vsi5004/RDJ-Turntable/docs/hmi-minimal-preview.png

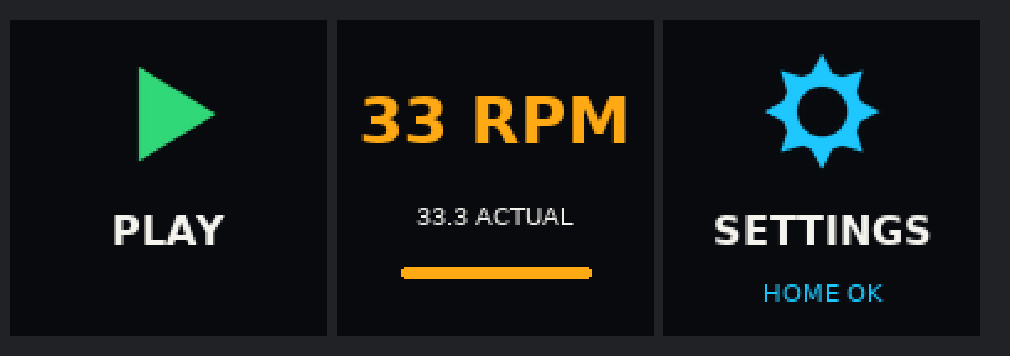
docs/hmi-minimal-preview.png
