vsi5004/RDJ-Turntable/RDJ-Turntable.ioc

Mcu.UserName=STM32F407VETx
PA0-WKUP.Signal=S_TIM2_CH1_ETR
PA1.Signal=S_TIM2_CH2
PA10.Signal=S_TIM1_CH3
PA13.Signal=SYS_JTMS-SWDIO
PA14.Signal=SYS_JTCK-SWCLK
PA2.GPIO_Label=PLAT_INDEX
PA2.Signal=GPXTI2
PA4.GPIO_Label=MT_CS
PA4.Signal=GPIO_Output
PA5.Signal=SPI1_SCK
PA6.Signal=SPI1_MISO
PA7.Signal=SPI1_MOSI
PA8.Signal=S_TIM1_CH1
PA9.Signal=S_TIM1_CH2
PB0.Signal=S_TIM3_CH3
PB10.Signal=SPI2_SCK
PB12.GPIO_Label=AS_CS
PB12.Signal=GPIO_Output
PB13.GPIO_Label=PLAT_EN
PB13.Signal=GPIO_Output
PB14.GPIO_Label=PLAT_FAULT
PB14.Signal=GPIO_Input
PB15.Signal=S_TIM12_CH2
PB3.Signal=SPI3_SCK
PB5.Signal=SPI3_MOSI
PB8.Signal=CAN1_RX
PB9.Signal=CAN1_TX
PC0.Signal=ADCx_IN10
PC13-ANTI_TAMP.GPIO_Label=LED
PC13-ANTI_TAMP.Signal=GPIO_Output
PC2.Signal=SPI2_MISO
PC3.Signal=SPI2_MOSI
PC4.GPIO_Label=ARM_EN
PC4.Signal=GPIO_Output
PC5.GPIO_Label=ARM_FAULT
PC5.Signal=GPIO_Input
PC6.Signal=S_TIM3_CH1
PC7.Signal=S_TIM3_CH2
PD12.GPIO_Label=DISP_BL
PD12.Signal=S_TIM4_CH1
PE10.GPIO_Label=KEY2
PE10.Signal=GPIO_Input
PE2.GPIO_Label=DISP_DC
PE2.Signal=GPIO_Output
PE3.GPIO_Label=DISP_RST
PE3.Signal=GPIO_Output
PE4.GPIO_Label=DISP_CS0
PE4.Signal=GPIO_Output
PE5.GPIO_Label=DISP_CS1
PE5.Signal=GPIO_Output
PE6.GPIO_Label=DISP_CS2
PE6.Signal=GPIO_Output
PE7.GPIO_Label=ARM_HOME
PE7.Signal=GPXTI7
PE8.GPIO_Label=KEY0
PE8.Signal=GPIO_Input
PE9.GPIO_Label=KEY1
PE9.Signal=GPIO_Input
PH0-OSC_IN.Signal=RCC_OSC_IN
PH1-OSC_OUT.Signal=RCC_OSC_OUT
