vsi5004/RDJ-Turntable/Core/Inc/main.h

#define DISP_DC_Pin GPIO_PIN_2
#define DISP_DC_GPIO_Port GPIOE
#define DISP_RST_Pin GPIO_PIN_3
#define DISP_RST_GPIO_Port GPIOE
#define DISP_CS0_Pin GPIO_PIN_4
#define DISP_CS0_GPIO_Port GPIOE
#define DISP_CS1_Pin GPIO_PIN_5
#define DISP_CS1_GPIO_Port GPIOE
#define DISP_CS2_Pin GPIO_PIN_6
#define DISP_CS2_GPIO_Port GPIOE
#define LED_Pin GPIO_PIN_13
#define LED_GPIO_Port GPIOC
#define PLAT_INDEX_Pin GPIO_PIN_2
#define PLAT_INDEX_GPIO_Port GPIOA
#define PLAT_INDEX_EXTI_IRQn EXTI2_IRQn
#define MT_CS_Pin GPIO_PIN_4
#define MT_CS_GPIO_Port GPIOA
#define ARM_EN_Pin GPIO_PIN_4
#define ARM_EN_GPIO_Port GPIOC
#define ARM_FAULT_Pin GPIO_PIN_5
#define ARM_FAULT_GPIO_Port GPIOC
#define ARM_HOME_Pin GPIO_PIN_7
#define ARM_HOME_GPIO_Port GPIOE
#define ARM_HOME_EXTI_IRQn EXTI9_5_IRQn
#define KEY0_Pin GPIO_PIN_8
#define KEY0_GPIO_Port GPIOE
#define KEY1_Pin GPIO_PIN_9
#define KEY1_GPIO_Port GPIOE
#define KEY2_Pin GPIO_PIN_10
#define KEY2_GPIO_Port GPIOE
#define AS_CS_Pin GPIO_PIN_12
#define AS_CS_GPIO_Port GPIOB
#define PLAT_EN_Pin GPIO_PIN_13
#define PLAT_EN_GPIO_Port GPIOB
#define PLAT_FAULT_Pin GPIO_PIN_14
#define PLAT_FAULT_GPIO_Port GPIOB
#define DISP_BL_Pin GPIO_PIN_12
#define DISP_BL_GPIO_Port GPIOD
