vsi5004/RDJ-Turntable/App/diagnostics/m2c_executor.cpp

#include "m2c_executor.hpp"

#include "control/arm_foc.h"
#include "control/as5048a.h"
#include "control/foc.h"
#include "control/mt6826s.h"
#include "nvm.h"
#include "trace.h"

#include <cmath>

namespace diagnostics {
namespace {

constexpr float kPi = 3.14159265358979f;
constexpr float kTwoPi = 2.0f * kPi;
constexpr float kOpenLoopElecVel = kTwoPi;
constexpr float kBeltRatio = 90.0f / 24.0f;
constexpr float kMotorVelocity33 = 33.3333f * kBeltRatio * (kTwoPi / 60.0f);
constexpr float kCalRpm = 180.0f;
constexpr uint8_t kCalFreq = 0x5;
constexpr float kCalVoltage = 3.0f;
constexpr float kArmJogStep = kPi / 2.0f; /* default carriage jog: 90 deg motor angle */
constexpr uint32_t kJogSettleMs = 300;    /* min dwell before a jog can report Complete */
constexpr uint32_t kJogTimeoutMs = 4000;  /* jog must reach target within this or it fails */

float shortest_delta(float a, float b)
{
    float d = a - b;
    if (d > kPi) d -= kTwoPi;
    if (d < -kPi) d += kTwoPi;
    return d;
}

}  // namespace

/* --- Per-motor dispatch: the platter (foc/MT6826S) and the tonearm carriage (arm_foc/AS5048A) are
 * the same axis abstraction for the shared diagnostics (electrical align, encoder read, stop,
 * fault). Routing by command_.target lets the align state machine below serve both motors. --- */

bool M2cExecutor::is_tonearm() const { return command_.target == Target::TonearmCarriage; }

void M2cExecutor::motor_hold_electrical_angle(float theta_el)
{
    if (is_tonearm()) arm_foc::hold_electrical_angle(theta_el);
    else              foc::hold_electrical_angle(theta_el);
}

void M2cExecutor::motor_set_open_loop_electrical_velocity(float elec_rad_s)
{
    if (is_tonearm()) arm_foc::set_open_loop_electrical_velocity(elec_rad_s);
    else              foc::set_open_loop_electrical_velocity(elec_rad_s);
}

bool M2cExecutor::motor_faulted() const
{
    return is_tonearm() ? arm_foc::faulted() : foc::faulted();
}

bool M2cExecutor::commit_alignment(float offset, int dir)
{
    if (is_tonearm()) {
        arm_foc::zero_elec_offset = offset;
        arm_foc::direction = static_cast<int8_t>(dir);
        arm_foc::alignment_valid = true;
        return nvm::save(nvm::Slot::Tonearm, nvm::Cal{offset, dir});
    }
    foc::zero_elec_offset = offset;
    foc::direction = static_cast<int8_t>(dir);
    foc::alignment_valid = true;
    return nvm::save(nvm::Slot::Platter, nvm::Cal{foc::zero_elec_offset, foc::direction});
}

/* Stop BOTH motors. Diagnostics never drives both at once, so disabling both on any abort/exit is
 * the safe default and avoids leaving the inactive axis energized. */
void M2cExecutor::stop_motors()
{
    foc::stop();
    arm_foc::stop();
}

bool M2cExecutor::start(const Command& command)
{
    if (phase_ != Phase::Idle) return false;
    command_ = command;
    report_ = {ExecutionState::Running};
    phase_started_ms_ = clock_.now_ms();

    switch (command.action) {
    case Action::ReadStatus:
        phase_ = Phase::ReadStatus;
        return true;
    case Action::OpenLoopSpin:
        spin_elec_vel_ = command.parameters.value != 0.0f ? command.parameters.value
                                                          : kOpenLoopElecVel;
        motor_set_open_loop_electrical_velocity(spin_elec_vel_);
        phase_ = Phase::Continuous;
        trace_ms_ = clock_.now_ms();
        spin_mech_accum_ = 0.0f;
        spin_primed_ = false;
        TRACE(is_tonearm() ? "diag: tonearm open-loop spin (auto pole-pair count)\n"
                           : "diag: platter open-loop started\n");
        return true;
    case Action::ElectricalAlign:
        motor_hold_electrical_angle(0.0f);
        phase_ = Phase::AlignWaitZero;
        TRACE("diag: electrical alignment started\n");
        return true;
    case Action::EncoderAutoCal:
        mt6826s::set_autocal_freq(kCalFreq);
        saved_voltage_limit_ = foc::voltage_limit;
        cal_voltage_saved_ = true;
        foc::voltage_limit = kCalVoltage;
        cal_ramp_step_ = 1;
        foc::set_open_loop_electrical_velocity(
            (kCalRpm / 60.0f) * kTwoPi * foc::pole_pairs / 40.0f);
        phase_ = Phase::CalRamp;
        TRACE("diag: encoder auto-cal ramp started\n");
        return true;
    case Action::ClosedLoopVelocity: {
        const float target =
            command.parameters.value != 0.0f ? command.parameters.value : kMotorVelocity33;
        report_.platter_calibrated = foc::alignment_valid;
        if (foc::alignment_valid) {
            foc::set_closed_loop_velocity(target);
            TRACE("diag: platter velocity loop started (closed-loop)\n");
        } else {
            /* No stored alignment: spin open-loop at the same target so wiring can be checked.
             * The UI shows OPEN so the operator knows to run align/auto-cal for closed-loop. */
            foc::set_open_loop_velocity(target);
            TRACE("diag: platter velocity open-loop fallback; run align/cal\n");
        }
        phase_ = Phase::Continuous;
        return true;
    }
    case Action::Jog: {
        /* Tonearm carriage position jog (closed-loop position needs commutation alignment first). */
        if (!arm_foc::alignment_valid) {
            report_ = {ExecutionState::Failed, -10};
            TRACE("diag: jog rejected; tonearm not aligned\n");
            return false;
        }
        const float delta =
            command.parameters.value != 0.0f ? command.parameters.value : kArmJogStep;
        arm_foc::jog(delta);
        phase_ = Phase::JogSettle;
        trace_ms_ = clock_.now_ms();
        TRACE("diag: tonearm carriage jog started\n");
        return true;
    }
    case Action::Stop:
        safe_stop();
        report_ = {ExecutionState::Complete};
        return true;
    default:
        report_ = {ExecutionState::Failed, -1};
        return false;
    }
}

void M2cExecutor::abort()
{
    if (phase_ == Phase::CalPoll) mt6826s::stop_autocal();
    stop_motors();
    restore_calibration_voltage();
    phase_ = Phase::Idle;
    report_ = {ExecutionState::Idle};
    TRACE("diag: operation aborted; motors disabled\n");
}

void M2cExecutor::safe_stop()
{
    if (phase_ == Phase::CalPoll) mt6826s::stop_autocal();
    stop_motors();
    restore_calibration_voltage();
    phase_ = Phase::Idle;
    report_ = {ExecutionState::Idle};
}

ExecutionReport M2cExecutor::poll()
{
    report_.platter_calibrated = foc::alignment_valid;
    if (phase_ == Phase::Idle) return report_;

    if (motor_faulted()) {
        finish(ExecutionState::Failed, -2);
        return report_;
    }

    switch (phase_) {
    case Phase::Continuous:
        if (command_.action == Action::ClosedLoopVelocity) {
            report_.primary = foc::velocity();
            report_.secondary = foc::applied_uq();
        } else { /* OpenLoopSpin (any motor): auto pole-pair count */
            estimate_pole_pairs();
        }
        break;

    case Phase::ReadStatus: {
        mt6826s::Reading reading;
        mt6826s::read(reading);
        report_.primary = mt6826s::degrees(reading.angle);
        report_.secondary = static_cast<float>(reading.status);
        finish(reading.crc_ok ? ExecutionState::Complete : ExecutionState::Failed,
               reading.crc_ok ? 0 : -3);
        break;
    }

    case Phase::AlignWaitZero:
        if (elapsed(900)) {
            if (!read_mechanical_rad(align_m0_)) {
                finish(ExecutionState::Failed, -3);
                break;
            }
            motor_hold_electrical_angle(kPi / 3.0f);
            phase_started_ms_ = clock_.now_ms();
            phase_ = Phase::AlignWaitStep;
        }
        break;

    case Phase::AlignWaitStep:
        if (elapsed(900)) {
            float m1 = 0.0f;
            if (!read_mechanical_rad(m1)) {
                finish(ExecutionState::Failed, -3);
                break;
            }
            const float dmech = shortest_delta(m1, align_m0_);
            const int dir = dmech >= 0.0f ? 1 : -1;
            const bool saved = commit_alignment(align_m0_, dir); /* persists to flash per motor */
            report_.primary = align_m0_ * (180.0f / kPi);
            report_.secondary = dmech * (180.0f / kPi);
            TRACE("diag: align offset=%u deg dir=%c save=%s\n",
                  static_cast<unsigned>(report_.primary), dir > 0 ? '+' : '-',
                  saved ? "OK" : "FAILED");
            finish(saved ? ExecutionState::Complete : ExecutionState::Failed, saved ? 0 : -4);
        }
        break;

    case Phase::CalRamp:
        if (elapsed(50)) {
            ++cal_ramp_step_;
            if (cal_ramp_step_ > 40) {
                phase_ = Phase::CalSettle;
            } else {
                const float target = (kCalRpm / 60.0f) * kTwoPi * foc::pole_pairs;
                foc::set_open_loop_electrical_velocity(target * cal_ramp_step_ / 40.0f);
            }
            phase_started_ms_ = clock_.now_ms();
        }
        break;

    case Phase::CalSettle:
        if (elapsed(1000)) {
            if (!read_mechanical_rad(cal_angle0_)) {
                finish(ExecutionState::Failed, -3);
                break;
            }
            phase_started_ms_ = clock_.now_ms();
            phase_ = Phase::CalMeasure;
        }
        break;

    case Phase::CalMeasure:
        if (elapsed(100)) {
            float angle1 = 0.0f;
            if (!read_mechanical_rad(angle1)) {
                finish(ExecutionState::Failed, -3);
                break;
            }
            const float delta = shortest_delta(angle1, cal_angle0_);
            const float rpm = std::fabs((delta / 0.1f) * (60.0f / kTwoPi));
            report_.primary = rpm;
            if (rpm < 80.0f || rpm > 200.0f) {
                TRACE("diag: auto-cal speed out of band (%ld RPM)\n",
                      static_cast<long>(rpm));
                finish(ExecutionState::Failed, -5);
            } else {
                mt6826s::start_autocal();
                cal_poll_count_ = 0;
                phase_started_ms_ = clock_.now_ms();
                phase_ = Phase::CalPoll;
                TRACE("diag: encoder auto-cal running\n");
            }
        }
        break;

    case Phase::CalPoll:
        if (elapsed(100)) {
            phase_started_ms_ = clock_.now_ms();
            ++cal_poll_count_;
            const mt6826s::CalStatus status = mt6826s::autocal_status();
            report_.secondary = static_cast<float>(status);
            if (status == mt6826s::CalStatus::Success) {
                TRACE("diag: encoder auto-cal success; power-cycle required\n");
                finish(ExecutionState::Complete);
            } else if (status == mt6826s::CalStatus::Failed || cal_poll_count_ >= 200) {
                mt6826s::stop_autocal();
                finish(ExecutionState::Failed,
                       status == mt6826s::CalStatus::Failed ? -6 : -7);
            }
        }
        break;

    case Phase::JogSettle: {
        const float pos_deg = arm_foc::position() * (180.0f / kPi);
        const float tgt_deg = arm_foc::position_target() * (180.0f / kPi);
        report_.primary = pos_deg;
        report_.secondary = tgt_deg - pos_deg;
        if (static_cast<uint32_t>(clock_.now_ms() - trace_ms_) >= 100) {
            trace_ms_ = clock_.now_ms();
            /* All fields integer to stay clear of float printf: positions/error in deci-degrees,
             * Uq in mV, velocity in milli-rad/s. */
            TRACE("diag: jog tgt=%ld pos=%ld err=%ld [deci-deg] Uq=%ldmV vel=%ldmrad/s\n",
                  static_cast<long>(tgt_deg * 10.0f), static_cast<long>(pos_deg * 10.0f),
                  static_cast<long>((tgt_deg - pos_deg) * 10.0f),
                  static_cast<long>(arm_foc::applied_uq() * 1000.0f),
                  static_cast<long>(arm_foc::velocity() * 1000.0f));
        }
        if (arm_foc::position_settled() && elapsed(kJogSettleMs)) {
            /* Target reached. Keep arm_foc in Position mode HOLDING (do not stop the motor); just
             * mark the command complete so the controller returns to Ready while the carriage holds.
             * The next jog adds to the held target; exit/abort disables the motor. */
            phase_ = Phase::Idle;
            report_.state = ExecutionState::Complete;
            report_.result_code = 0;
            TRACE("diag: tonearm jog reached target (holding)\n");
        } else if (elapsed(kJogTimeoutMs)) {
            finish(ExecutionState::Failed, -11);
            TRACE("diag: tonearm jog did not reach target\n");
        }
        break;
    }

    case Phase::Idle:
        break;
    }

    return report_;
}

void M2cExecutor::estimate_pole_pairs()
{
    /* Open-loop spin: the ISR drives the electrical angle but does NOT sample the encoder (true for
     * both foc and arm_foc), so reading it here on the main loop is safe. The commanded electrical
     * angle is exactly vel*time, and a synchronous rotor advances mech = elec / pole_pairs, so
     * pole_pairs = elec_travelled / mech_travelled. Motor-agnostic via read_mechanical_rad(). */
    float mech = 0.0f;
    if (!read_mechanical_rad(mech)) return;

    if (!spin_primed_) {
        if (elapsed(500)) { /* let the rotor lock to the open-loop field before measuring */
            spin_mech_prev_ = mech;
            spin_mech_accum_ = 0.0f;
            spin_accum_ms_ = clock_.now_ms();
            spin_primed_ = true;
        }
        return;
    }

    float d = mech - spin_mech_prev_;
    if (d > kPi) d -= kTwoPi;
    if (d < -kPi) d += kTwoPi;
    spin_mech_accum_ += d;
    spin_mech_prev_ = mech;

    const float elec =
        spin_elec_vel_ * static_cast<float>(clock_.now_ms() - spin_accum_ms_) / 1000.0f;
    const float mech_mag = std::fabs(spin_mech_accum_);
    if (mech_mag <= 0.20f) return; /* wait for enough travel for a stable ratio */

    report_.primary = std::fabs(elec) / mech_mag;
    if (static_cast<uint32_t>(clock_.now_ms() - trace_ms_) < 250) return;
    trace_ms_ = clock_.now_ms();
    const int32_t p100 = static_cast<int32_t>(report_.primary * 100.0f);
    TRACE("diag: %s pole_pairs est=%ld.%02ld (mech %ld deg)\n",
          is_tonearm() ? "tonearm" : "platter", static_cast<long>(p100 / 100),
          static_cast<long>(p100 % 100), static_cast<long>(mech_mag * 180.0f / kPi));
}

bool M2cExecutor::read_mechanical_rad(float& angle)
{
    if (is_tonearm()) {
        as5048a::Reading r;
        as5048a::read(r);
        if (!r.parity_ok) return false;
        angle = static_cast<float>(r.angle) * (kTwoPi / 16384.0f); /* AS5048A 14-bit */
        return true;
    }
    mt6826s::Reading reading;
    mt6826s::read(reading);
    if (!reading.crc_ok) return false;
    angle = static_cast<float>(reading.angle) * (kTwoPi / 32768.0f); /* MT6826S 15-bit */
    return true;
}

void M2cExecutor::finish(ExecutionState state, int32_t result_code)
{
    if (phase_ == Phase::CalPoll && state == ExecutionState::Failed)
        mt6826s::stop_autocal();
    stop_motors();
    restore_calibration_voltage();
    phase_ = Phase::Idle;
    report_.state = state;
    report_.result_code = result_code;
}

void M2cExecutor::restore_calibration_voltage()
{
    if (!cal_voltage_saved_) return;
    foc::voltage_limit = saved_voltage_limit_;
    cal_voltage_saved_ = false;
}

bool M2cExecutor::elapsed(uint32_t duration_ms) const
{
    return static_cast<uint32_t>(clock_.now_ms() - phase_started_ms_) >= duration_ms;
}

}  // namespace diagnostics
