vsi5004/RDJ-Turntable/App/platform/nvm.h

/**
 * nvm.h - tiny non-volatile store for commutation-critical calibration, in MCU flash.
 *
 * Holds the FOC alignment (zero electrical offset + direction sign) so the platter motor
 * commutates correctly from boot without re-aligning each power-on. Lives in internal flash
 * (not the removable SD card) precisely because the motor depends on it. One dedicated flash
 * sector; writes are rare (only on re-align), well within endurance.
 */
#pragma once
#include <cstdint>

namespace nvm {

/* One alignment per motor, each in its own dedicated flash sector. */
enum class Slot : uint8_t {
    Platter, /* sector 7 @ 0x08060000 */
    Tonearm, /* sector 6 @ 0x08040000 */
};

struct Cal {
    float   zero_offset; /* mechanical angle (rad) where theta_elec == 0 */
    int32_t direction;   /* +1 / -1 */
};

/* Load the stored calibration for a motor. Returns false if none is present / fails validation. */
bool load(Slot slot, Cal& out);

/* Erase + program a motor's calibration sector. Returns true on success. Stalls the CPU for the
 * duration of the sector erase (~1 s) — call only with the motors stopped. */
bool save(Slot slot, const Cal& in);

}  // namespace nvm
