vsi5004/RDJ-Turntable/App/hmi/screenkey_demo.cpp

#include "screenkey_demo.hpp"

namespace hmi {
namespace {

float selected_rpm(turntable::RecordSpeed speed)
{
    return speed == turntable::RecordSpeed::Rpm45 ? 45.0f : 33.3333f;
}

bool is_playback_state(turntable::State state)
{
    using turntable::State;
    switch (state) {
    case State::SpinningUpForPlay:
    case State::SeekingLeadIn:
    case State::LoweringForPlay:
    case State::Playing:
    case State::RaisingForPause:
    case State::Paused:
    case State::LoweringForResume:
    case State::RaisingForSpeedChange:
    case State::ChangingSpeedForPlayback:
    case State::LoweringAfterSpeedChange:
    case State::ChangingSpeedWhilePaused:
    case State::RaisingForStop:
    case State::ReturningHomeWithPlatter:
    case State::StoppingPlatter:
    case State::SpinningUpForResume:
        return true;
    default:
        return false;
    }
}

constexpr int16_t kRippleMillirpm[] = {
    0, 6, 13, 20, 25, 28, 26, 21, 14, 6, -2, -10, -17, -22, -25, -23,
    -18, -10, -1, 8, 16, 22, 25, 23, 18, 11, 4, -3, -9, -12, -10, -5,
};

}  // namespace

void ScreenKeyDemo::reset(uint32_t now_ms)
{
    interaction_ = InteractionController(interaction_config_);
    application_ = {};
    application_.authority = turntable::ControlAuthority::Normal;
    application_.state = turntable::ApplicationState::Normal;
    application_.turntable.selected_speed = turntable::RecordSpeed::Rpm33;
    application_.turntable.home = turntable::HomeConfidence::Unknown;
    application_.turntable.lift.position = turntable::LiftPosition::Unknown;
    application_.turntable.lift.confidence = turntable::PositionConfidence::Unknown;
    deadline_ = Deadline::None;
    deadline_started_ms_ = now_ms;
    deadline_duration_ms_ = 0;
    speed_trace_.reset();
    set_state(turntable::State::NeedsHome);
}

void ScreenKeyDemo::handle(Key key, Gesture gesture, uint32_t now_ms)
{
    interaction_.synchronize(application_);
    if (key == Key::Settings && gesture == Gesture::Hold
        && application_.authority == turntable::ControlAuthority::Normal
        && interaction_.snapshot().mode == Mode::Primary) {
        inject_product_fault();
        return;
    }
    apply(interaction_.handle(key, gesture, application_), now_ms);
}

void ScreenKeyDemo::tick(uint32_t now_ms)
{
    update_speed_trace(now_ms);
    if (application_.authority == turntable::ControlAuthority::Diagnostic && diagnostic_ != nullptr) {
        diagnostic_->tick();
        sync_diagnostic();
    }
    if (deadline_ == Deadline::None
        || static_cast<uint32_t>(now_ms - deadline_started_ms_) < deadline_duration_ms_)
        return;
    const Deadline elapsed = deadline_;
    deadline_ = Deadline::None;
    advance(elapsed, now_ms);
    interaction_.synchronize(application_);
}

void ScreenKeyDemo::apply(const Intent& intent, uint32_t now_ms)
{
    switch (intent.type) {
    case IntentType::None:
        break;
    case IntentType::TurntableEvent:
        apply_turntable_event(intent.event, now_ms);
        break;
    case IntentType::EnterDiagnostics:
        application_.state = turntable::ApplicationState::EnteringDiagnostic;
        application_.turntable.lift.motion = turntable::MotionState::Moving;
        schedule(Deadline::FinishDiagnosticEntry, 600, now_ms);
        break;
    case IntentType::ExitDiagnostics:
        if (diagnostic_ != nullptr) diagnostic_->request_exit();
        application_.state = turntable::ApplicationState::ExitingDiagnostic;
        schedule(Deadline::FinishDiagnosticExit, 500, now_ms);
        sync_diagnostic();
        break;
    case IntentType::SubmitDiagnostic:
        if (diagnostic_ != nullptr) diagnostic_->submit(intent.diagnostic);
        sync_diagnostic();
        break;
    case IntentType::AbortDiagnostic:
        if (diagnostic_ != nullptr) diagnostic_->abort();
        sync_diagnostic();
        break;
    case IntentType::AcknowledgeDiagnosticFault:
        if (diagnostic_ != nullptr) diagnostic_->acknowledge_fault();
        sync_diagnostic();
        break;
    }
}

void ScreenKeyDemo::apply_turntable_event(const turntable::Event& event, uint32_t now_ms)
{
    using turntable::EventType;
    using turntable::State;
    switch (event.type) {
    case EventType::InitializeRequested:
        set_state(State::RaisingForInitialization);
        schedule(Deadline::BeginHoming, 600, now_ms);
        break;
    case EventType::CancelRequested:
        deadline_ = Deadline::None;
        set_state(State::NeedsHome);
        break;
    case EventType::PlayRequested:
        speed_trace_.reset();
        set_state(State::SpinningUpForPlay);
        schedule(Deadline::BeginSeeking, 1000, now_ms);
        break;
    case EventType::PauseRequested:
        set_state(State::RaisingForPause);
        schedule(Deadline::FinishPause, 600, now_ms);
        break;
    case EventType::ResumeRequested:
        set_state(State::LoweringForResume);
        schedule(Deadline::FinishResume, 600, now_ms);
        break;
    case EventType::StopRequested:
        if (application_.turntable.state == State::Interrupted) {
            set_state(State::ReturningHomeWithoutPlatter);
            schedule(Deadline::FinishReturnWithoutPlatter, 800, now_ms);
        } else {
            set_state(State::RaisingForStop);
            schedule(Deadline::BeginReturn, 600, now_ms);
        }
        break;
    case EventType::SpeedChangeRequested:
        speed_trace_.reset();
        application_.turntable.selected_speed = event.speed;
        if (application_.turntable.state == State::Playing) {
            set_state(State::RaisingForSpeedChange);
            schedule(Deadline::BeginSpeedChange, 600, now_ms);
        } else if (application_.turntable.state == State::Paused) {
            set_state(State::ChangingSpeedWhilePaused);
            schedule(Deadline::FinishSpeedChange, 800, now_ms);
        } else {
            update_actions();
        }
        break;
    case EventType::AcknowledgeFaultRequested:
        application_.turntable.fault = {};
        set_state(application_.turntable.home == turntable::HomeConfidence::Valid
                      ? State::Interrupted : State::NeedsHome);
        break;
    case EventType::MaintenanceCancelRequested:
        set_state(application_.turntable.home == turntable::HomeConfidence::Valid
                      ? State::Idle : State::NeedsHome);
        break;
    default:
        break;
    }
}

void ScreenKeyDemo::set_state(turntable::State state)
{
    application_.turntable.state = state;
    using turntable::LiftPosition;
    using turntable::MotionState;
    using turntable::State;
    switch (state) {
    case State::RaisingForInitialization:
    case State::RaisingForPause:
    case State::RaisingForSpeedChange:
    case State::RaisingForStop:
        application_.turntable.lift.motion = MotionState::Moving;
        break;
    case State::LoweringForPlay:
    case State::LoweringForResume:
    case State::LoweringAfterSpeedChange:
        application_.turntable.lift.motion = MotionState::Moving;
        break;
    case State::Playing:
        application_.turntable.lift.position = LiftPosition::Lowered;
        application_.turntable.lift.motion = MotionState::Idle;
        application_.turntable.measured_rpm = selected_rpm(application_.turntable.selected_speed);
        application_.turntable.speed_locked = true;
        break;
    case State::Paused:
        application_.turntable.lift.position = LiftPosition::Raised;
        application_.turntable.lift.motion = MotionState::Idle;
        application_.turntable.measured_rpm = selected_rpm(application_.turntable.selected_speed);
        application_.turntable.speed_locked = true;
        break;
    case State::Idle:
    case State::NeedsHome:
        speed_trace_.reset();
        application_.turntable.lift.position = LiftPosition::Raised;
        application_.turntable.lift.motion = MotionState::Idle;
        application_.turntable.measured_rpm = 0.0f;
        application_.turntable.speed_locked = false;
        break;
    case State::Fault:
        speed_trace_.reset();
        application_.turntable.lift.position = LiftPosition::Raised;
        application_.turntable.lift.motion = MotionState::Idle;
        application_.turntable.measured_rpm = 0.0f;
        application_.turntable.speed_locked = false;
        break;
    default:
        if (is_playback_state(state))
            application_.turntable.measured_rpm = selected_rpm(
                application_.turntable.selected_speed);
        break;
    }
    update_actions();
}

void ScreenKeyDemo::update_speed_trace(uint32_t now_ms)
{
    const bool valid = application_.turntable.speed_locked
        && application_.turntable.measured_rpm > 0.0f;
    if (!valid) {
        speed_trace_.update(now_ms, 0.0f, 0.0f, false);
        return;
    }

    const float target = selected_rpm(application_.turntable.selected_speed);
    constexpr uint32_t kRippleCount = sizeof(kRippleMillirpm) / sizeof(kRippleMillirpm[0]);
    const int16_t ripple = kRippleMillirpm[(now_ms / 100u) % kRippleCount];
    application_.turntable.measured_rpm = target + static_cast<float>(ripple) / 1000.0f;
    speed_trace_.update(now_ms, target, application_.turntable.measured_rpm, true);
}

void ScreenKeyDemo::update_actions()
{
    application_.turntable.actions = {};
    turntable::ActionSet& actions = application_.turntable.actions;
    actions.add(turntable::Action::OpenSettings);
    using turntable::Action;
    using turntable::State;
    switch (application_.turntable.state) {
    case State::NeedsHome:
        actions.add(Action::Initialize);
        actions.add(Action::SelectSpeed);
        actions.add(Action::EnterDiagnostics);
        break;
    case State::RaisingForInitialization:
    case State::HomingCarriage:
    case State::ParkingCarriage:
        actions.add(Action::Cancel);
        break;
    case State::Idle:
        actions.add(Action::Play);
        actions.add(Action::SelectSpeed);
        actions.add(Action::EnterDiagnostics);
        break;
    case State::Playing:
        actions.add(Action::Pause);
        actions.add(Action::Stop);
        actions.add(Action::SelectSpeed);
        break;
    case State::Paused:
    case State::Interrupted:
        actions.add(Action::Resume);
        actions.add(Action::Stop);
        actions.add(Action::SelectSpeed);
        break;
    case State::Fault:
        actions.add(Action::AcknowledgeFault);
        actions.add(Action::FaultDetails);
        break;
    case State::Maintenance:
        actions.add(Action::Cancel);
        break;
    case State::StoppingPlatter:
        break;
    default:
        actions.add(Action::Stop);
        break;
    }
}

void ScreenKeyDemo::schedule(Deadline deadline, uint32_t duration_ms, uint32_t now_ms)
{
    deadline_ = deadline;
    deadline_started_ms_ = now_ms;
    deadline_duration_ms_ = duration_ms;
}

void ScreenKeyDemo::advance(Deadline deadline, uint32_t now_ms)
{
    using turntable::State;
    switch (deadline) {
    case Deadline::None:
        break;
    case Deadline::BeginHoming:
        set_state(State::HomingCarriage);
        schedule(Deadline::BeginParking, 1200, now_ms);
        break;
    case Deadline::BeginParking:
        application_.turntable.carriage_position_mm = 0.0f;
        set_state(State::ParkingCarriage);
        schedule(Deadline::FinishInitialization, 600, now_ms);
        break;
    case Deadline::FinishInitialization:
        application_.turntable.home = turntable::HomeConfidence::Valid;
        application_.turntable.carriage_position_mm = 3.0f;
        application_.turntable.lift.confidence = turntable::PositionConfidence::Estimated;
        set_state(State::Idle);
        break;
    case Deadline::BeginSeeking:
        application_.turntable.measured_rpm = selected_rpm(application_.turntable.selected_speed);
        application_.turntable.speed_locked = true;
        set_state(State::SeekingLeadIn);
        schedule(Deadline::BeginLoweringForPlay, 600, now_ms);
        break;
    case Deadline::BeginLoweringForPlay:
        application_.turntable.carriage_position_mm = 8.0f;
        set_state(State::LoweringForPlay);
        schedule(Deadline::FinishPlay, 600, now_ms);
        break;
    case Deadline::FinishPlay:
        set_state(State::Playing);
        break;
    case Deadline::FinishPause:
        set_state(State::Paused);
        break;
    case Deadline::FinishResume:
        set_state(State::Playing);
        break;
    case Deadline::BeginSpeedChange:
        application_.turntable.lift.position = turntable::LiftPosition::Raised;
        set_state(State::ChangingSpeedForPlayback);
        schedule(Deadline::BeginLoweringAfterSpeedChange, 800, now_ms);
        break;
    case Deadline::BeginLoweringAfterSpeedChange:
        application_.turntable.measured_rpm = selected_rpm(application_.turntable.selected_speed);
        application_.turntable.lift.position = turntable::LiftPosition::Lowered;
        set_state(State::LoweringAfterSpeedChange);
        schedule(Deadline::FinishSpeedChange, 600, now_ms);
        break;
    case Deadline::FinishSpeedChange:
        set_state(application_.turntable.lift.position == turntable::LiftPosition::Raised
                      ? State::Paused : State::Playing);
        break;
    case Deadline::BeginReturn:
        application_.turntable.lift.position = turntable::LiftPosition::Raised;
        set_state(State::ReturningHomeWithPlatter);
        schedule(Deadline::BeginPlatterStop, 800, now_ms);
        break;
    case Deadline::BeginPlatterStop:
        application_.turntable.carriage_position_mm = 3.0f;
        set_state(State::StoppingPlatter);
        schedule(Deadline::FinishStop, 600, now_ms);
        break;
    case Deadline::FinishStop:
    case Deadline::FinishReturnWithoutPlatter:
        application_.turntable.carriage_position_mm = 3.0f;
        set_state(State::Idle);
        break;
    case Deadline::FinishDiagnosticEntry:
        application_.turntable.lift.position = turntable::LiftPosition::Raised;
        application_.turntable.lift.motion = turntable::MotionState::Idle;
        application_.authority = turntable::ControlAuthority::Diagnostic;
        application_.state = turntable::ApplicationState::Diagnostic;
        application_.diagnostic = {};
        if (diagnostic_ != nullptr) diagnostic_->enter();
        sync_diagnostic();
        break;
    case Deadline::FinishDiagnosticExit:
        application_.authority = turntable::ControlAuthority::Normal;
        application_.state = turntable::ApplicationState::Normal;
        application_.diagnostic = {};
        set_state(application_.turntable.home == turntable::HomeConfidence::Valid
                      ? State::Idle : State::NeedsHome);
        break;
    }
}

void ScreenKeyDemo::inject_product_fault()
{
    deadline_ = Deadline::None;
    application_.turntable.home = turntable::HomeConfidence::Unknown;
    application_.turntable.fault = {
        turntable::FaultCode::CarriageStall, turntable::FaultSource::Carriage,
        turntable::RecoveryPolicy::RequiresCarriageHome, true, 0};
    set_state(turntable::State::Fault);
    interaction_.synchronize(application_);
}

void ScreenKeyDemo::sync_diagnostic()
{
    if (diagnostic_ != nullptr) application_.diagnostic = diagnostic_->snapshot();
}

}  // namespace hmi
