vsi5004/RDJ-Turntable/App/hmi/screenkey_demo.hpp

#pragma once

#include "control/platter_feedback.hpp"
#include "interaction_controller.hpp"

#include <cstdint>

namespace hmi {

class ScreenKeyDemo {
public:
    /* The normal-operation screens stay simulated (no mechanics on the bench), but diagnostics are
     * delegated to a real diagnostics::Controller when one is supplied so the platter motor and its
     * encoder calibration run for real. With no controller (host tests) diagnostics are inert. */
    explicit ScreenKeyDemo(InteractionConfig config = {},
                           diagnostics::Controller* diagnostic = nullptr)
        : interaction_config_(config), interaction_(config), diagnostic_(diagnostic) {}

    void reset(uint32_t now_ms = 0);
    void handle(Key key, Gesture gesture, uint32_t now_ms);
    void tick(uint32_t now_ms);

    const turntable::ApplicationSnapshot& application_snapshot() const { return application_; }
    NavigationSnapshot navigation_snapshot() const { return interaction_.snapshot(); }
    const platter_feedback::SpeedTrace& speed_trace() const { return speed_trace_; }

private:
    enum class Deadline : uint8_t {
        None,
        BeginHoming,
        BeginParking,
        FinishInitialization,
        BeginSeeking,
        BeginLoweringForPlay,
        FinishPlay,
        FinishPause,
        FinishResume,
        BeginSpeedChange,
        BeginLoweringAfterSpeedChange,
        FinishSpeedChange,
        BeginReturn,
        BeginPlatterStop,
        FinishStop,
        FinishReturnWithoutPlatter,
        FinishDiagnosticEntry,
        FinishDiagnosticExit,
    };

    void apply(const Intent& intent, uint32_t now_ms);
    void apply_turntable_event(const turntable::Event& event, uint32_t now_ms);
    void set_state(turntable::State state);
    void update_actions();
    void schedule(Deadline deadline, uint32_t duration_ms, uint32_t now_ms);
    void advance(Deadline deadline, uint32_t now_ms);
    void inject_product_fault();
    void sync_diagnostic();
    void update_speed_trace(uint32_t now_ms);

    InteractionConfig interaction_config_{};
    InteractionController interaction_;
    diagnostics::Controller* diagnostic_ = nullptr;
    turntable::ApplicationSnapshot application_{};
    Deadline deadline_ = Deadline::None;
    uint32_t deadline_started_ms_ = 0;
    uint32_t deadline_duration_ms_ = 0;
    platter_feedback::SpeedTrace speed_trace_{};
};

}  // namespace hmi
