vsi5004/RDJ-Turntable/(commit log)

2026-06-22 Add Milestone 0 firmware baseline: STM32F407 HAL project + blink/RTT
    Native STM32 HAL project for the FK407M1-V1.1 (STM32F407VET6), generated
    via CubeMX with a CMake/Ninja + arm-none-eabi-gcc toolchain (no Arduino).
    - Clocks: 168 MHz from the 8 MHz HSE crystal (PLLM=8/N=336/P=2/Q=7),
    SWD debug, PC13 user LED (active-low)
    - App/ layer seam: app_init()/app_run() called from main.c USER CODE blocks
    - App/app.c: ~2 Hz LED blink + SEGGER RTT trace of SYSCLK and a tick counter
    - Vendored SEGGER RTT (third_party/SEGGER_RTT) with stock (de-Zephyr'd) config
    - .vscode: CMake build tasks, cortex-debug/J-Link launch, IntelliSense config
    - docs/M0-cubemx-setup.md: reproducible CubeMX configuration
    Ve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
2026-06-22 M1: ScreenKey display bring-up (SPI3 + DMA, 3 panels)
    Add the HMI display layer driving the Waveshare ScreenKey panels
    (128x128 ST7735) over a shared SPI3 bus with per-screen CS.
    - CubeMX: SPI3 (8-bit, mode 0, 21 MHz, TX-only) on PB3/PB5 with
    SPI3_TX DMA (DMA1_Stream5); shared DISP_DC/RST/BL (PE2/PE3/PD12);
    per-screen CS PE4-6 and KEY PE8-10 (pull-up, active-low)
    - App/hmi/st7735.c: command-table init (INITR_144GREENTAB + INVON),
    windowed RAM write, DMA framebuffer push
    - App/hmi/screens.c: N-screen array (3, sized for 4), one shared 32 KB
    byte-swapped RGB565 framebuffer, key polling
    - app.c: non-blocking main loop (tick-based LED heartbeat + key poll)
    - Clock now durably 168 MHz fr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
    [RDJ-Turntable.ioc, display_config.h, main.h, screens.h, st7735.h]
2026-06-22 docs + tooling: two-encoder architecture, MT6826S calibration, PDF search
    - record-player-design-log.md: tonearm encoder is AS5048A (not MT6826S);
    encoders split across SPI1 (MT6826S) / SPI2 (AS5048A), with rationale
    - docs/M2a-cubemx-setup.md: SPI1 + MT6826S bring-up guide
    - docs/mt6826s-calibration.md: User Auto-Calibration procedure (for M2c)
    - tools/pdfsearch.py: PyMuPDF-based datasheet text search
2026-06-22 M2a + C++ App layer: MT6826S encoder, GPIO wrappers, faster boot
    Encoder (M2a):
    - CubeMX SPI1 (mode 3, ~10.5 MHz, full-duplex) + MT_CS on PA4
    - App/control/mt6826s: burst-read driver with CRC-8 validation; absolute
    angle streamed over RTT (verified tracking by hand-rotating the magnet)
    C++ App layer (converted from C):
    - App/*.cpp, C++17; one namespace per driver, static constexpr constants,
    enum class status; app_init/app_run stay extern "C" for the main.c seam
    - App/platform/gpio.hpp + button.hpp: polarity-aware OutputPin/InputPin + Button
    - constexpr RGB565 colors (replacing the #define macros)
    Boot speedup (~3 s -> ~0.4 s):
    - drop redundant software SWRESET (hw_reset covers it); SL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
2026-06-23 M2b: AS5048A tonearm encoder on SPI2
    - CubeMX SPI2 (mode 1, 16-bit, ~5.25 MHz, full-duplex) on PB10/PC2/PC3 + AS_CS (PB12)
    - App/control/as5048a: pipelined double-read of 0xFFFF, 14-bit angle, even-parity
    validation (the bench correctness check, like the MT6826S CRC)
    - app.cpp streams both encoders (MT6826S on SPI1, AS5048A on SPI2) over RTT
    - docs/M2b-cubemx-setup.md
    Verified on hardware: AS5048A angle tracks with parity=OK; MT6826S still good.
    [RDJ-Turntable.ioc, app.cpp, as5048a.cpp, as5048a.h, main.h]
2026-06-23 M2c: platter FOC — open-loop spin, encoder align, closed-loop velocity
    TIM1 3-PWM (PA8/9/10, 20kHz center-aligned, RCR=1, update ISR) driving the
    SimpleFOC Mini (DRV8313) in BLDCDriver3PWM mode; EN=PB13, nFAULT=PB14, 24V bus.
    Hand-rolled voltage-mode FOC (inverse Park/Clarke, sine LUT) in App/control/foc.
    - M2c-1 open-loop spin: confirmed pole_pairs=7 (51.4 deg mech per elec rev).
    - M2c-2 encoder align: solve zero-offset + direction from the MT6826S.
    - M2c-3a closed-loop torque commutation (q-axis).
    - M2c-3b closed-loop velocity PI (1 kHz) with velocity LPF; target from belt
    ratio (33.333 RPM platter, 90/24 pulleys -> 13.09 rad/s motor); mean speed
    holds on target under load.
    ISR rou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
2026-06-23 M2c-4: MT6826S user auto-calibration (open-loop), verified
    Adds single-register read/write + auto-cal SPI primitives to the MT6826S driver
    (IRQ-masked so they can't collide with the closed-loop ISR's burst read), and a
    KEY1 long-hold calibration routine.
    Calibration must run OPEN-LOOP at constant speed: the closed-loop velocity PI
    reads the uncalibrated angle and injects eccentricity-synchronized ripple, which
    fails the cal. The routine ramps open-loop to ~180 RPM, verifies the shaft speed
    via the encoder, then triggers self-cal (0x5E -> 0x155) and polls 0x113[7:6].
    Auto-cal self-commits to EEPROM on success (no separate Program EEPROM step) ->
    power-cycle. AUTOCAL_FREQ=0x5 (100-200 RPM) ma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
    [app.cpp, mt6826s.cpp, mt6826s.h]
2026-06-23 M2c hardening: raw bounded SPI read + flash-persisted alignment
    - MT6826S burst/register reads now use a raw, bounded-spin SPI1 transfer instead
    of HAL_SPI_TransmitReceive(HAL_MAX_DELAY). Removes the "hang the priority-0 FOC
    ISR forever" failure mode and cuts per-call overhead; driver no longer depends
    on HAL SPI. read() reports crc_ok=false on transfer timeout.
    - foc sample_encoder() holds the last good angle on a failed/bad read, so a
    transient bus glitch can't inject a garbage commutation angle.
    - New nvm module persists the FOC alignment (zero offset + direction) in flash
    sector 7 with a magic+checksum guard. Loaded at boot (closed loop ready without
    re-aligning), saved on KE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
    [app.cpp, foc.cpp, mt6826s.cpp, nvm.cpp, nvm.h]
2026-06-25 Drive the real platter motor in ScreenKey diagnostics
    The ScreenKey demo build previously disabled FOC and faked every
    diagnostic command. Wire its diagnostic intents to a real
    diagnostics::Controller + M2cExecutor so the platter motor and its
    encoder calibration run for real on the bench; normal-operation screens
    stay simulated since the mechanics aren't present.
    In diagnostics, the velocity loop now spins the platter at the motor
    target derived from the pre-selected record speed (33 1/3 vs 45 RPM)
    times the 90/24 belt ratio. ClosedLoopVelocity falls back to open-loop
    when no alignment is stored (instead of hard-failing), and the CONTROL
    key shows CLOSED LOOP vs OPEN: RUN CAL so the operat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
    [app.cpp, diagnostic_controller.hpp, interaction_controller.cpp, interaction_controller.hpp, m2c_executor.cpp, presenter.cpp, screenkey_demo.cpp, screenkey_demo.hpp]
2026-06-25 Add tonearm gimbal motor: second SimpleFOC Mini + carriage jog diagnostic
    Hardware (via CubeMX): a second SimpleFOC Mini (DRV8313) for the tonearm
    carriage gimbal motor on TIM3 CH1/2/3 = PC6/PC7/PB0 (edge-aligned
    ~20 kHz), with ARM_EN (PC4) and ARM_FAULT (PC5). TIM3 was chosen over the
    advanced-timer TIM8 to keep the microSD bank (PC8-12, PD2) free; the
    DRV8313 uses no complementary/dead-time/break features, so a GP timer
    costs nothing here. TIM2/TIM5 + PA0-2 stay reserved for the platter ABI
    encoder.
    Driver software mirrors the platter FOC:
    - arm_foc.{h,cpp}: voltage-mode FOC for TIM3 + AS5048A, with a
    closed-loop POSITION (PD) mode (the carriage is a servo, not a
    spindle) plus jog(del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
2026-06-25 Diagnostics test-browser UX, automatic pole-pair count, position PID
    Replace the per-target diagnostic shortcut pages (and their unintuitive
    hold-to-spin gestures) with a two-level browser per the state-machine
    doc: a target browser (KEY1 select / KEY2 next / KEY0 exit) opens a test
    browser where KEY2 scrolls the motor's test list and KEY1 runs the
    selected test. Every test is an explicit list entry, no hidden holds.
    PLATTER: SPIN, ALIGN, AUTO-CAL, VELOCITY
    TONEARM: ALIGN, JOG -, JOG +, SPIN
    The test catalog lives in interaction_controller (diag_test_count/label,
    shared with the presenter); turntable_sim now links it too.
    Pole-pairs are now measured, not timed: the SPIN test computes
    po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
    [interaction_controller.cpp, interaction_controller.hpp, m2c_executor.cpp, m2c_executor.hpp, presenter.cpp, test_main.cpp]
2026-06-25 Add remaining board IO: ABI encoder, endstop, CAN, lift servo, ADC + core temp
    CubeMX peripheral/pin additions completing the turntable's I/O:
    - Platter ABI encoder: TIM2 32-bit encoder mode (PA0=A/PA1=B, x4, filter 0xF)
    + index PA2=EXTI2 (PLAT_INDEX, pull-up/falling)
    - Tonearm home endstop: PE7=EXTI7 (ARM_HOME, pull-up/falling)
    - CAN bus for external TJA transceiver: CAN1 PB8=RX/PB9=TX (NVIC RX0)
    - Tonearm lift servo: TIM12_CH2/PB15, 50 Hz (PSC83/ARR19999, 1 us/count)
    - Tonearm angle + board temp: ADC1 scan+circular-DMA (DMA2_Stream0), ranks
    IN10/PC0 (arm angle), internal temp sensor, Vrefint; all 480 cycles
    Core-temperature readout (App/platform/board_temp): starts ADC1 DMA at boot
    a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
